SystemsCyber/CAN-Logger-3/assets/img/2018-11-29 15.38.34.jpg

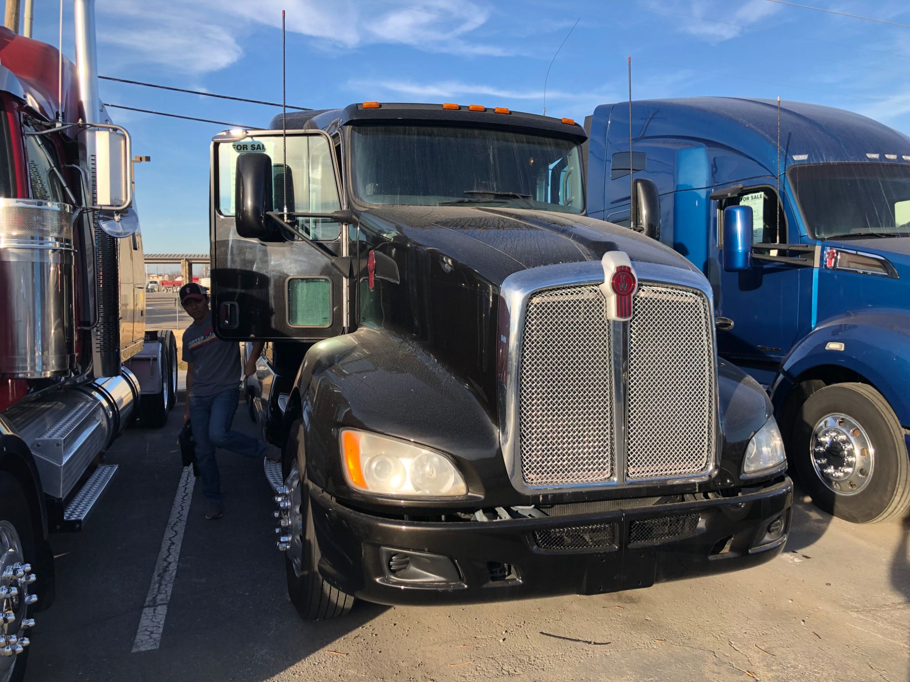
assets/img/2018-11-29 15.38.34.jpg
