SystemsCyber/CAN-Logger-3/images/CANLogger3CircuitBoard.jpg

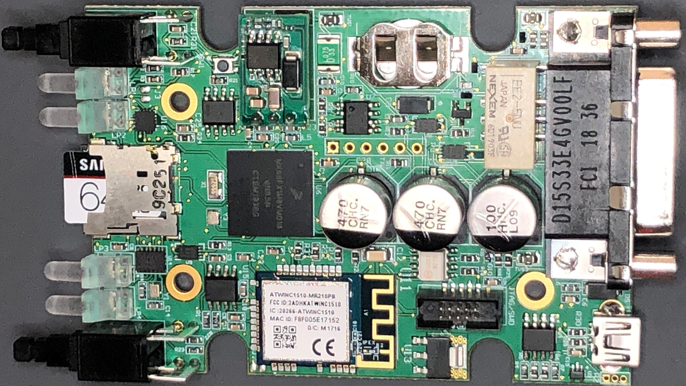
images/CANLogger3CircuitBoard.jpg
