SystemsCyber/CAN-Logger-3/CANDataBinaryStructure.png

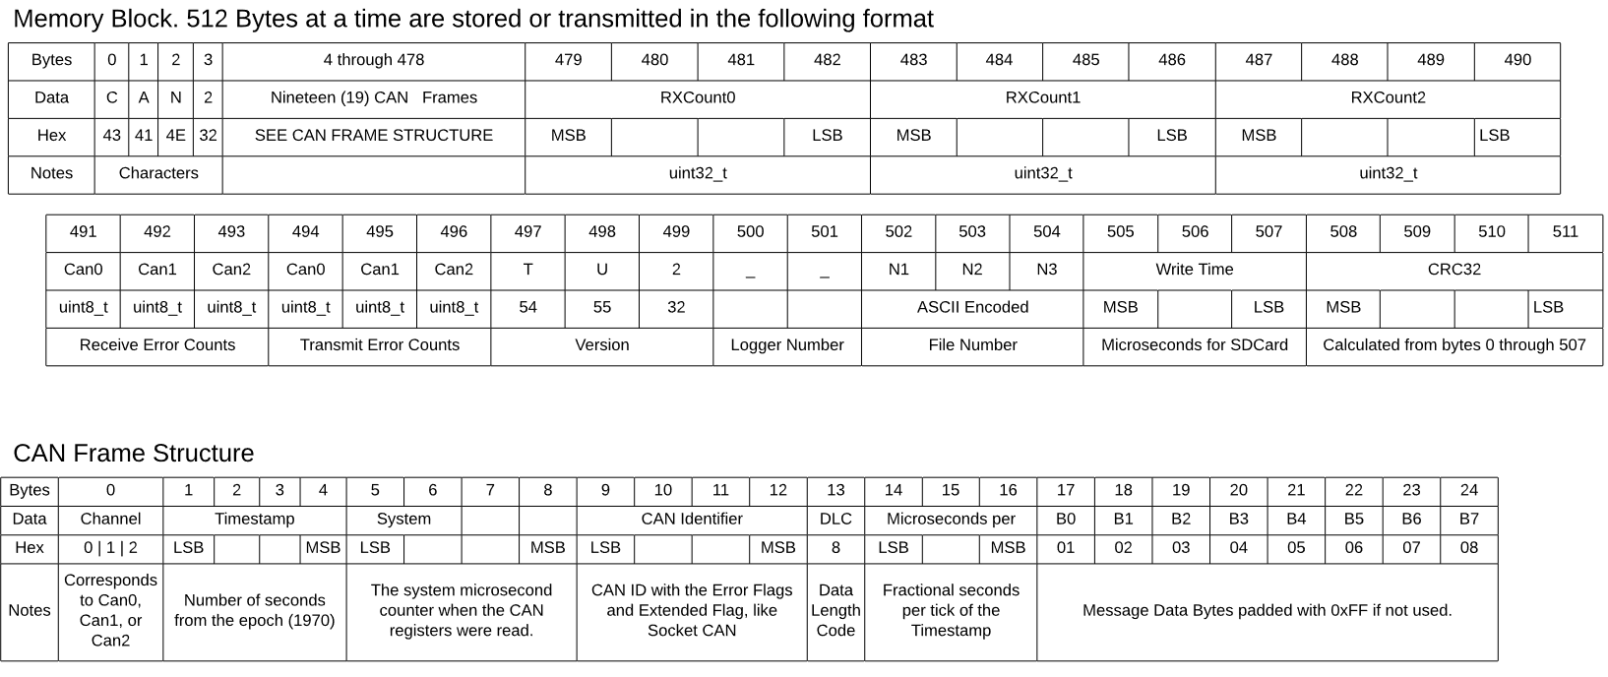
CANDataBinaryStructure.png
