SystemsCyber/CAN-Logger-3/(threads)

Thread 13 (2020-02-23):

Halt the program if the Encrypted Key is all zeros

jeremy-daily, 2020-02-23:
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

There's no way to use the data if this happens. We should rapidly flash all 4 LEDs on the logger if the ATECC chip doesn't calculate the session key.

jeremy-daily, 2020-02-23:
Let's add a check during upload to reject the data file so we don't populate the database and S3 bucket with garbage files (i.e. files we don't know the key for)

duyvan1995, 2020-02-23:
What are the conditions to reject the data?

Closed 2020-02-25.

Thread 19 (2020-06-30):

Add the ability to accurately set the time and timezone

jeremy-daily, 2020-06-30:
We need the ability to tune the clock to accurately keep track of time. Perhaps using NTP over the wifi. We need to also account for clock drift.

chris-lute, 2020-07-13:
@jeremy-daily what are your thoughts on logging all time as UTC on the CAN logger itself and setting the timezone on the client side?

jeremy-daily, 2020-07-13:
Good idea. The microprocessors are best to run on UTC.

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

Thread 27 (2020-09-22):

Client App Closes after provisioning one device

gannaramu, 2020-09-22:
the Client app closes itself due to an exception after one device is provisioned. I face this issue while I try to provision multiple devices. I need to open the client app every time.

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
