SystemsCyber/CAN-Logger-3/NMFTA_TU CAN Logger 3.pdf

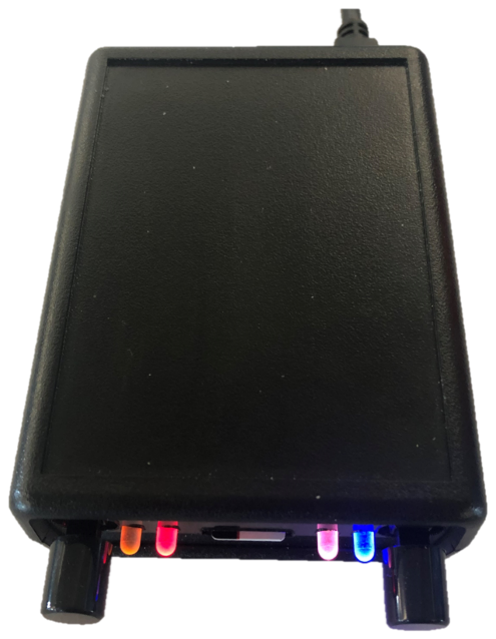
[picture p4: figure]
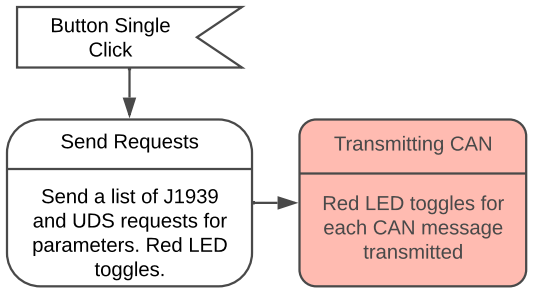
[picture p5: figure]
Transmitting CAN; Red LED toggles for each CAN message transmitted; Button Single Click; Send Requests; Send a list of J1939 and UDS requests for parameters. Red LED toggles.
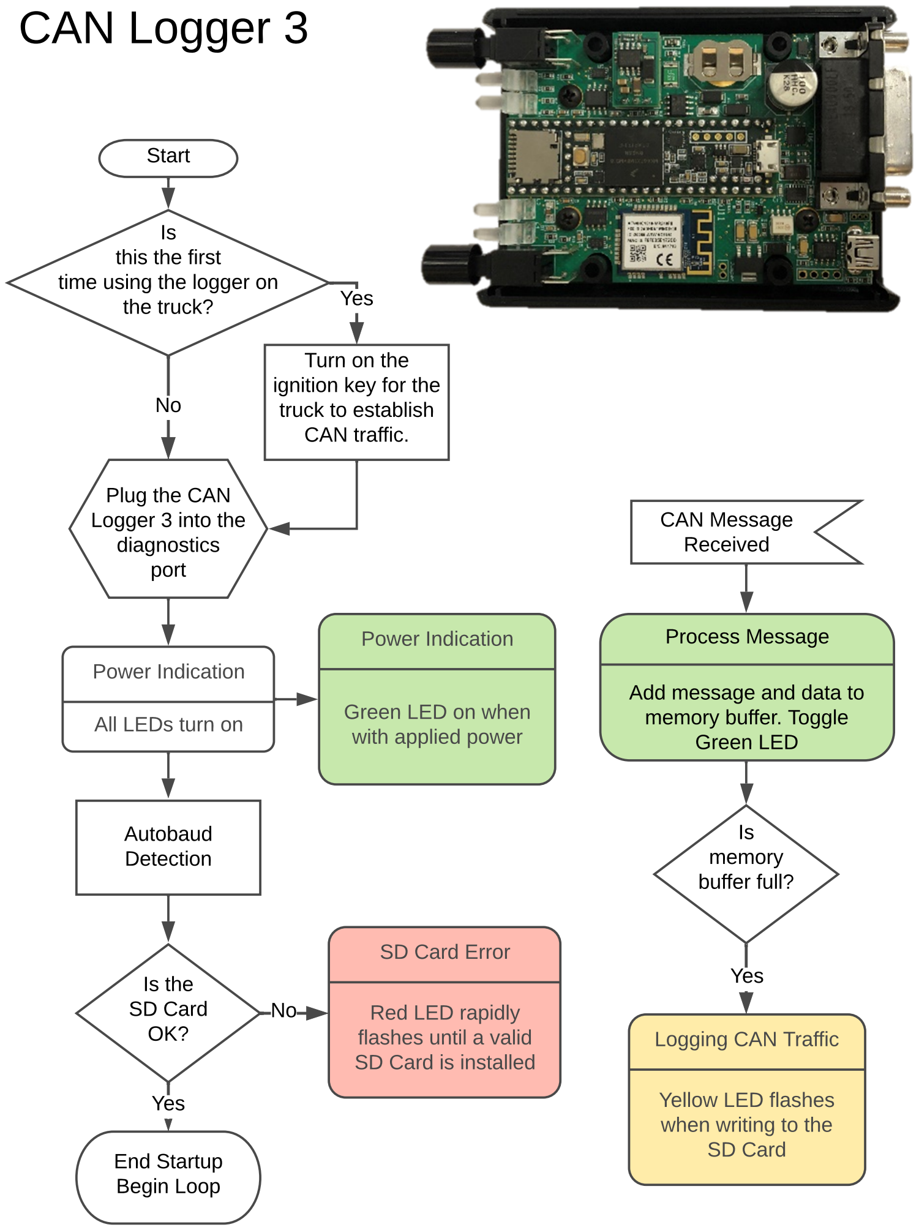
[picture p6: figure]
CAN Logger 3; Power Indication; All LEDs turn on; Start; Is this the first time using the logger on; the truck?; Yes; Turn on the ignition key for the truck to establish CAN traffic.; Plug the CAN Logger 3 into the diagnostics port; Logging CAN Traffic; Yellow LED flashes when writing to the SD Card; Autobaud Detection; End Startup Begin Loop; CAN Message Received; Process Message; Green LED on when with applied power; Is the SD Card OK?; SD Card Error; Red LED rapidly flashes until a valid SD Card is installed; Is memory; buffer full?

This material is based upon work supported by the National Science Foundation under Grant No. 1715409, titled

### "Detecting and Reconstructing Network Anomalies and Intrusions in Heavy Duty Vehicles"

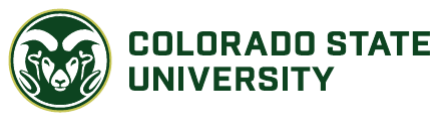
[picture p7: figure]
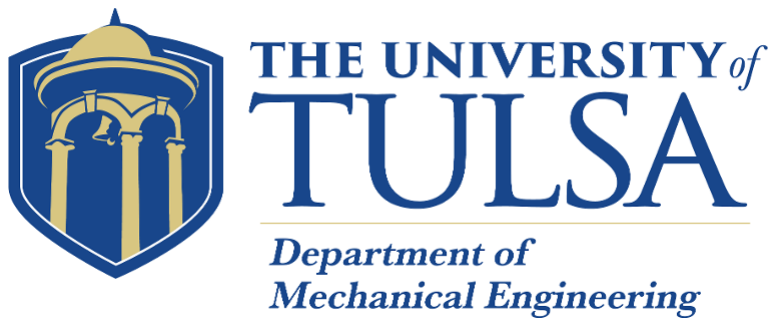
[picture p8: figure]
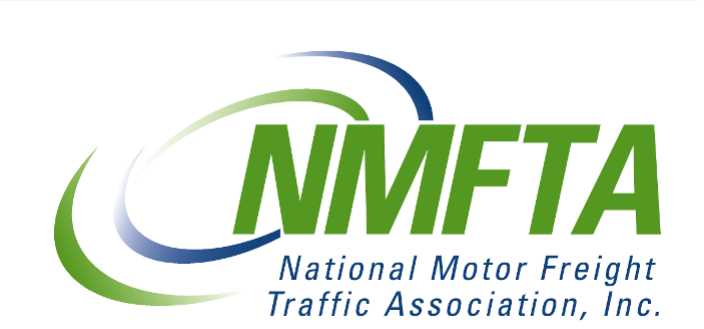
[picture p9: figure]

NMFTA/TU CAN Logger 3 | User Guide | Last Modified by: Jeremy Daily on 14-Jul-2022 | Page 1 of 6

Detecting Error Frames

Red LED flickers when
CAN bus error messages are detected.

Cable is unplugged
(power lost)

Shutdown

Close Current File

Add message and data to memory buffer. Toggle Green LED Button Double Click

Close File

Closes the file and
opens a new one in with the next

sequence number

CAN Bus Error

Process Error Message

Flag a message in the memory buffer by setting the 30th bit. Follow SocketCAN's error message handling.

LEDs Off

All LEDs turn off while new file is

created

Autobaud
Detection

End Startup
Begin Loop

Continue
Loop

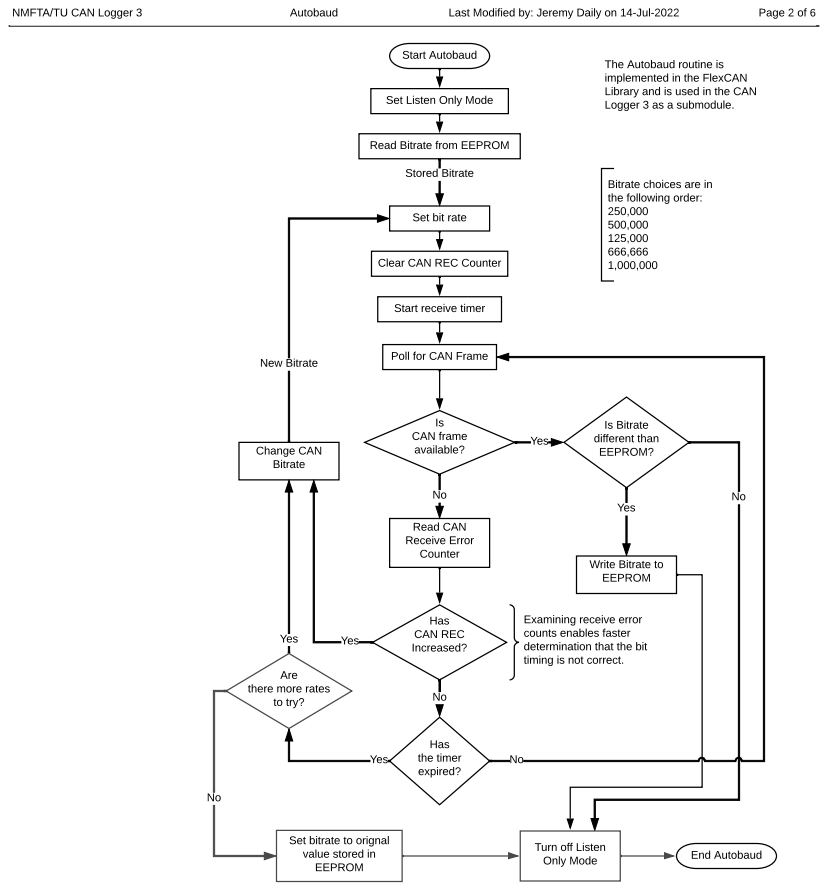
[picture p10: page 2]
Start Autobaud; Stored Bitrate; available?; Has CAN REC Increased?; Change CAN Bitrate; Yes; Is Bitrate different than EEPROM?; Has the timer expired?; New Bitrate; Bitrate choices are in the following order: 250,000 500,000 125,000 666,666 1,000,000; NMFTA/TU CAN Logger 3; Autobaud; Last Modified by: Jeremy Daily on 14-Jul-2022; Page 2 of 6; End Autobaud

The Autobaud routine is
implemented in the FlexCAN
Library and is used in the CAN
Logger 3 as a submodule.

Set Listen Only Mode

Read Bitrate from EEPROM

Set bit rate

Clear CAN REC Counter

Start receive timer

Poll for CAN Frame

Is CAN frame

Read CAN
Receive Error Counter

Write Bitrate to
EEPROM

Examining receive error
counts enables faster
determination that the bit
timing is not correct.

Are
there more rates
to try?

Set bitrate to orignal
value stored in

Turn off Listen Only Mode

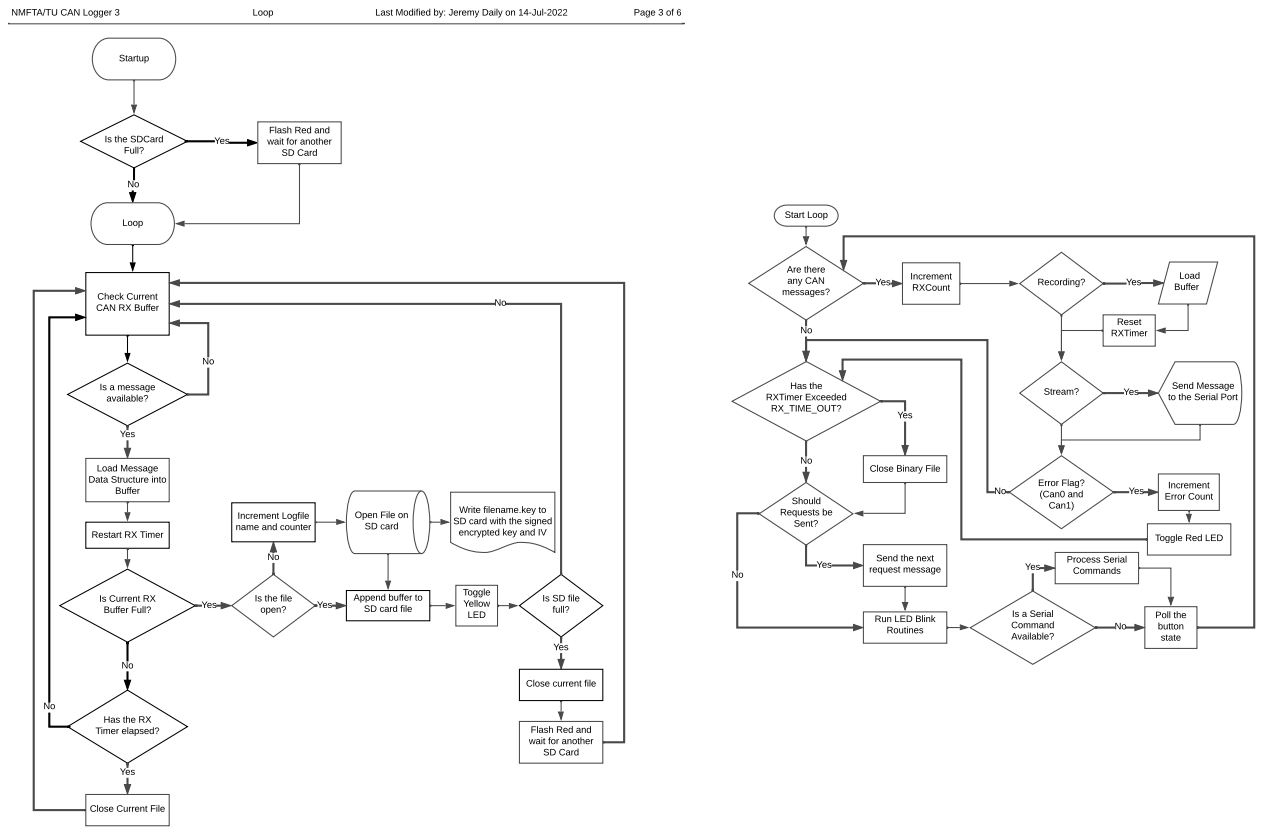
[picture p11: page 3]
Is a message available?; Yes; NMFTA/TU CAN Logger 3; Loop; Last Modified by: Jeremy Daily on 14-Jul-2022; Page 3 of 6; open?; Toggle Yellow LED; SD Card; Startup; Buffer; Start Loop; Increment; RXCount; Recording?; Load Buffer; Stream?; Send Message; Error Flag? (Can0 and Can1); Increment Error Count; Reset; RXTimer o; RX_TIME_OUT?; Should Requests be Sent?; Send the next; request message; Is a Serial Command Available?; Poll the button state; Process Serial Commands Yes

Flash Red and wait for another

Is the SDCard
Full?

Are there
any CAN messages?

Check Current
CAN RX Buffer

Has the RXTimer Exceeded

to the Serial Port

Load Message Data Structure into

Close Binary File

Increment Logfile
name and counter

Open File on
SD card

Write filename.key to
SD card with the signed
encrypted key and IV

Restart RX Timer

Toggle Red LED

Is Current RX
Buffer Full?

Is the file

Append buffer to
SD card file

Is SD file
full?

Run LED Blink
Routines

Close current file

Has the RX
Timer elapsed?

Flash Red and
wait for another
SD Card

Close Current File

Serial Commands | Interrupts

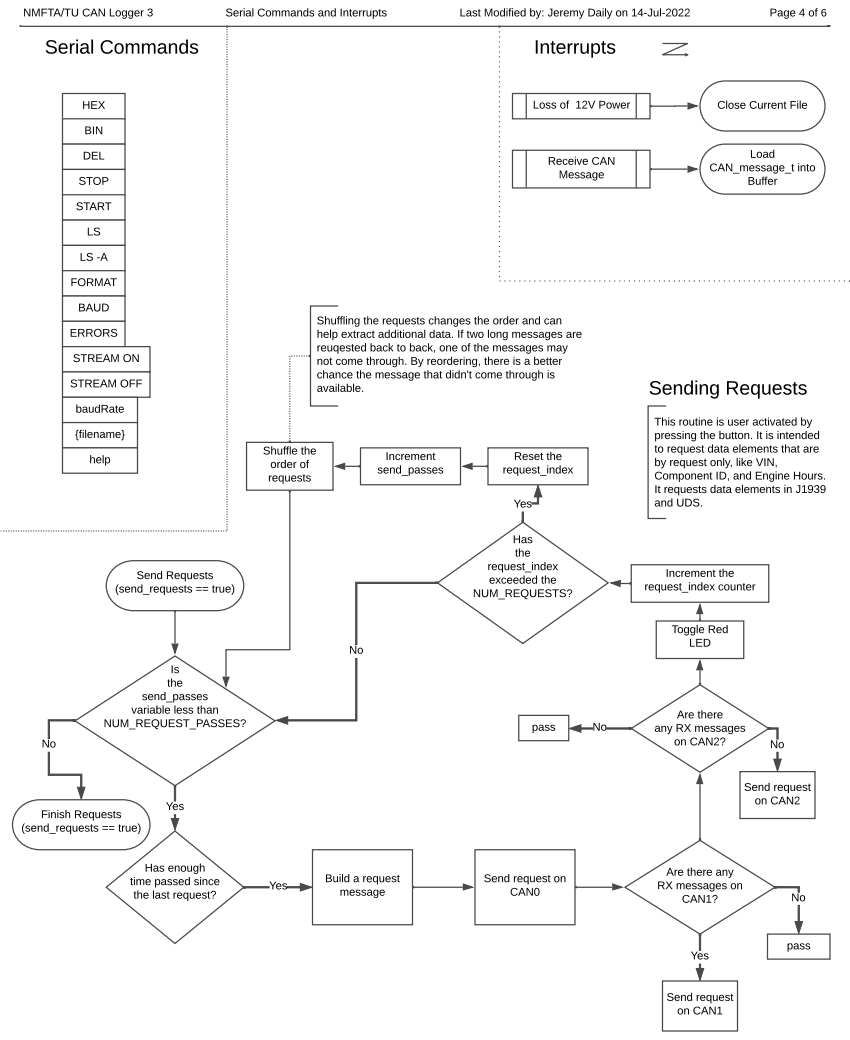
[picture p12: page 4]
NMFTA/TU CAN Logger 3; Serial Commands and Interrupts; Last Modified by: Jeremy Daily on 14-Jul-2022; Page 4 of 6; HEX; BIN; DEL; STOP; START; FORMAT; BAUD; ERRORS; STREAM ON; STREAM OFF; baudRate; {filename}; Loss of 12V Power; Close Current File; Receive CAN Message; Load CAN_message_t into Buffer; help; Send Requests (send_requests == true); Is the send_passes variable less than NUM_REQUEST_PASSES?; Yes; Build a request message; Send request on CAN1; pass; Send request on CAN2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

Shuffling the requests changes the order and can
help extract additional data. If two long messages are
reuqested back to back, one of the messages may
not come through. By reordering, there is a better
chance the message that didn't come through is

This routine is user activated by
pressing the button. It is intended
to request data elements that are
by request only, like VIN, Component ID, and Engine Hours.

It requests data elements in J1939
and UDS.

Are there
any RX messages
on CAN2?

Has enough
time passed since
the last request?

Send request on
CAN0

Are there any
RX messages on CAN1?

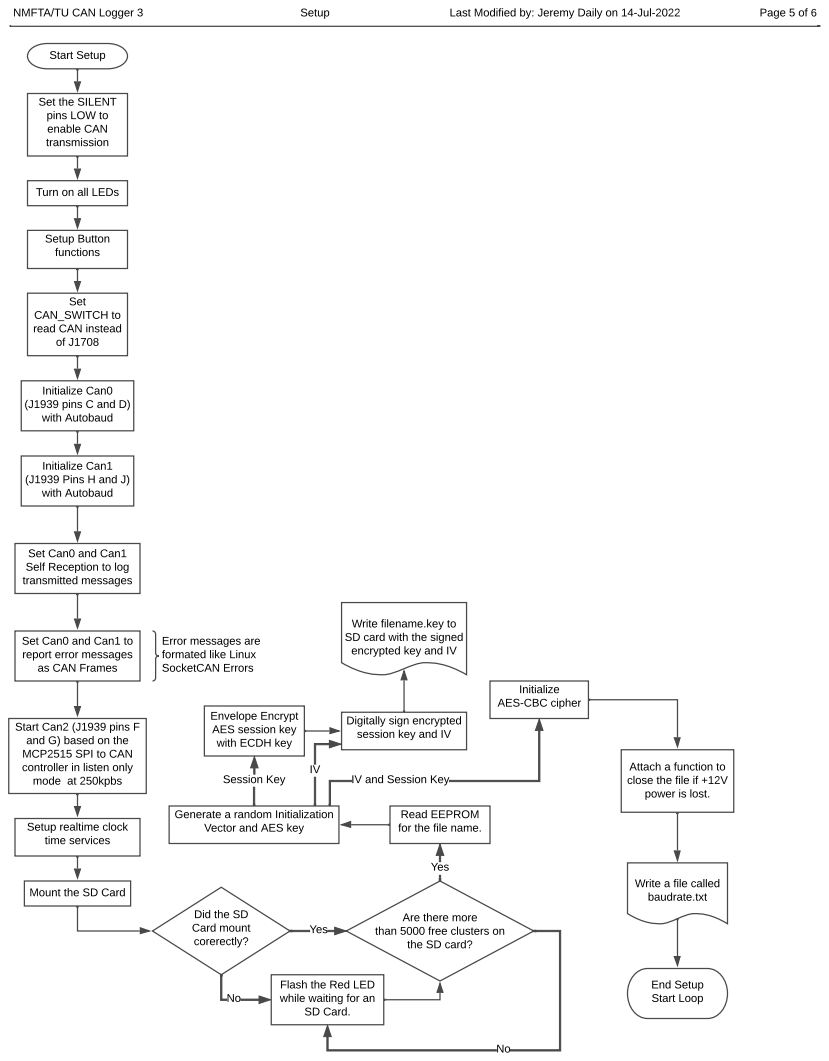
[picture p13: page 5]
NMFTA/TU CAN Logger 3; Setup; Last Modified by: Jeremy Daily on 14-Jul-2022; Page 5 of 6; Start Setup; Setup Button functions; Yes; End Setup Start Loop; Session Key; IV and Session Key

Set the SILENT
pins LOW to
enable CAN
transmission

Turn on all LEDs

Set
CAN_SWITCH to
read CAN instead

Initialize Can0
(J1939 pins C and D) with Autobaud

Initialize Can1
(J1939 Pins H and J) with Autobaud

Set Can0 and Can1
Self Reception to log
transmitted messages

Write filename.key to
SD card with the signed
encrypted key and IV

Set Can0 and Can1 to
report error messages
as CAN Frames

Error messages are
formated like Linux
SocketCAN Errors

Initialize
AES-CBC cipher

Envelope Encrypt
AES session key
with ECDH key

Start Can2 (J1939 pins F
and G) based on the MCP2515 SPI to CAN

Digitally sign encrypted
session key and IV

controller in listen only mode at 250kpbs

Attach a function to
close the file if +12V
power is lost.

Generate a random Initialization
Vector and AES key

Read EEPROM
for the file name.

Setup realtime clock
time services

Mount the SD Card

Write a file called
baudrate.txt

Did the SD
Card mount
corerectly?

Are there more
than 5000 free clusters on
the SD card?

Flash the Red LED
while waiting for an
SD Card.

ui nt 32_t i d; | / / can i dent i f i er
ui nt 32_t mi cr os; | / / syst em mi cr oseconds
ui nt 32_t r xcount ; | / / number of r ecei ved messages
ui nt 16_t t i mest amp; | / / Fl exCAN t i me when message ar r i ved
st r uct {
ui nt 8_t ext ended: 1; / / i dent i f i er i s ext ended ( 29- bi t )
ui nt 8_t r emot e: 1; / / r emot e t r ansmi ssi on r equest packet t ype ui nt 8_t over r un: 1; / / message over r un
ui nt 8_t r eser ved: 5;
} f l ags;
ui nt 8_t l en; | / / l engt h of dat a
ui nt 8_t buf [ 8] ; | / / dat a byt es
Bytes | 0 | 1 | 2 | 3 | 4 through 478 | 479 | 480 | 481 | 482 | 483 | 484 | 485 | 486 | 487 | 488 | 489 | 490
Data | C | A | N | 2 | Nineteen (19) CAN Frames | RXCount0 | | | | RXCount1 | | | | RXCount2
Hex | 43 | 41 | 4E | 32 | SEE CAN FRAME STRUCTURE | MSB | | | LSB | MSB | | | LSB | MSB | | | LSB
Notes | Characters | | | | | uint32_t | | | | uint32_t | | | | uint32_t
491 | 492 | 493 | 494 | 495 | 496 | 497 | 498 | 499 | 500 | 501 | 502 | 503 | 504 | 505 | 506 | 507 | 508 | 509 | 510 | 511
Can0 | Can1 | Can2 | Can0 | Can1 | Can2 | T | U | 2 | _ | _ | N1 | N2 | N3 | Write Time | | | CRC32
uint8_t | uint8_t | uint8_t | uint8_t | uint8_t | uint8_t | 54 | 55 | 32 | | ASCII Encoded | MSB | LSB | MSB | LSB
Receive Error Counts | | | Transmit Error Counts | | | Version | | | Logger Number | File Number | Microseconds for SDCard | | Calculated from bytes 0 through 507
Bytes | 0 | 1 | 2 | 3 | 4 | 5 | 6 | 7 | 8 | 9 | 10 | 11 | 12 | 13 | 14 | 15 | 16 | 17 | 18 | 19 | 20 | 21 | 22 | 23 | 24
Data | Channel | Timestamp | | | | System | | | | CAN Identifier | | | | DLC | Microseconds per | | | B0 | B1 | B2 | B3 | B4 | B5 | B6 | B7
Hex | 0 | 1 | 2 | LSB | | | MSB | LSB | | | MSB | LSB | | | MSB | 8 | LSB | | MSB | 01 | 02 | 03 | 04 | 05 | 06 | 07 | 08
Notes | Corresponds to Can0, Can1, or Can2 | Number of seconds from the epoch (1970) | | | | The system microsecond counter when the CAN registers were read. | | | | CAN ID with the Error Flags and Extended Flag, like Socket CAN | | | | Data Length Code | Fractional seconds per tick of the Timestamp | | | Message Data Bytes padded with 0xFF if not used.
0x00 | 0 | 1 | 2 | 3 | 4 | 5 | 6 | 7 | 8 | 9 | 10 | 11 | 12 | 13 | 14
Data | Bitrate | Bitrate | Bitrate | RES | 2 | _ | _ | null | N1 | N2 | N3 | null | T | U | null
Hex | | | | 32 | 0x00 | ASCII Encoded | | 0x00
Notes | Can0 Bitrate | Can1 Bitrate | Can2 Bitrate | Logger Identifier of 2 uppercase letters | | File ID. Each digit can be 0-9 or A-Z for a total of 36*3 = 46,656 files. | Brand Name of Logger (i.e. "TU") to start each filename.

## Memory Block. 512 Bytes at a time are stored or transmitted in the following format

NMFTA/TU CAN Logger 3 | Data Structures | Last Modified by: Jeremy Daily on 14-Jul-2022 | Page 6 of 6

## CAN Frame Structure

## EEPROM or Local Memory Map

## CAN_message_t
