SystemsCyber/CAN-Logger-3/(commit log)

2020-06-17 Seperate Branch for Managing Webpage
    [CAN Logger 3 Bill of Materials.xls, End Pannel with USB.DXF, End Pannel with button.DXF]
2020-09-16 Added an assembly checklist
2020-09-23 Top Logo Batch Printing
2021-02-05 Added union structure for micro timer.
    Added union
2021-03-11 Moved Pin Definitions to Header
    Moved the pin define statements to a header file. I couldn't find a hardware version number, so I just called it "Teensy-36-Mounted" because the Teensy 3.6 is mounted directly to the board, not embedded into it. I'm not married to the name, just the first thing I came up with
